Lamarn/ThermoAmpel/Dokumentation/Humidity_Conversion.png

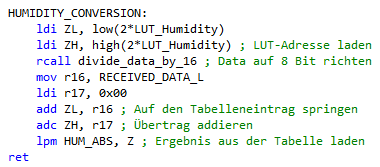
Dokumentation/Humidity_Conversion.png
