Lamarn/ThermoAmpel/Board/Thermoampel/v1microcontroller.brd

## EAGLE design Board/Thermoampel/v1microcontroller.brd (2018-10-14)

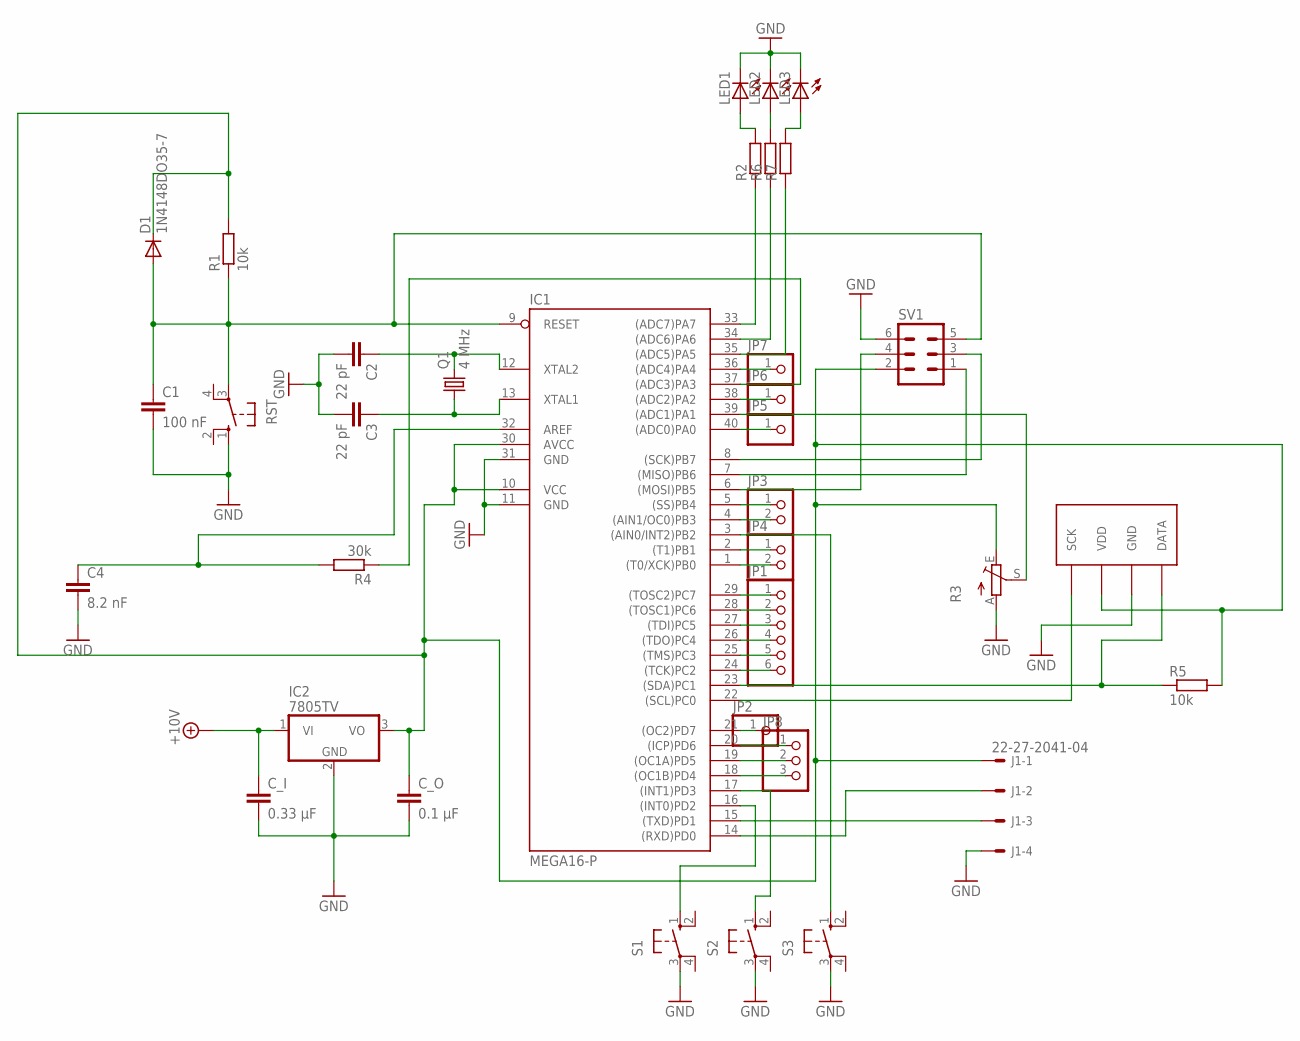
[picture p9: schematic v1microcontroller.sch]

Parts:
C1: 100 nF; C2.5-3
C2, C3: 22 pF; C2.5-3
C4: 8.2 nF; C2.5-3
C_I: 0.33 μF; C2.5-3
C_O: 0.1 μF; C2.5-3
D1: 1N4148DO35-7; DO35-7
IC1: MEGA16-P; DIL40
IC2: 7805TV; TO220V
J1: 22-27-2041-04; 6410-04
JP1: PINHD-1X6; 1X06
JP2, JP5, JP6, JP7: PINHD-1X1; 1X01
JP3, JP4: PINHD-1X2; 1X02
JP8: PINHD-1X3; 1X03
LED1, LED2, LED3: LED5MM
Q1: 4 MHz; HC49U-V
R1, R5: 10k; 0204/5
R2, R6, R7: R-EU_0204/5; 0204/5
R3: TRIM_EU-CT6; CT6
R4: 30k; 0204/5
RST: 10-XX; B3F-10XX
S1, S2, S3: 10-XX; B3F-10XX
SV1: ML6
U$1: SHT71; SHT7X

Connections:
+10V: C_I.1, IC2.1 (VI)
GND: C1.2, C2.2, C3.2, C4.2, C_I.2, C_O.2, IC1.11 (GND), IC1.31 (GND), IC2.2 (GND), J1.4, LED1.K (C), LED2.K (C), LED3.K (C), R3.A, RST.1 (S), S1.3, S2.3, S3.3, SV1.6, U$1.3 (GND)
unnamed: C1.1, D1.A, IC1.9 (RESET), R1.1, RST.3, SV1.5
unnamed: LED3.A, R7.2
unnamed: C_O.1, D1.C, IC1.10 (VCC), IC1.30 (AVCC), IC2.3 (VO), J1.1, R1.2, R3.E, R5.2, SV1.2, U$1.2 (VDD)
unnamed: IC1.33 ((ADC7)PA7), R2.1
unnamed: IC1.7 ((MISO)PB6), SV1.1
unnamed: IC1.6 ((MOSI)PB5), SV1.4
unnamed: LED2.A, R6.2
unnamed: C2.1, IC1.12 (XTAL2), Q1.2
unnamed: C3.1, IC1.13 (XTAL1), Q1.1
unnamed: IC1.39 ((ADC1)PA1), R3.S
unnamed: LED1.A, R2.2
unnamed: IC1.21 ((OC2)PD7), JP2.1
unnamed: C4.1, IC1.32 (AREF), R4.2
unnamed: IC1.8 ((SCK)PB7), SV1.3
unnamed: IC1.20 ((ICP)PD6), JP8.1
unnamed: IC1.19 ((OC1A)PD5), JP8.2
unnamed: IC1.18 ((OC1B)PD4), JP8.3
unnamed: IC1.29 ((TOSC2)PC7), JP1.1
unnamed: IC1.15 ((TXD)PD1), J1.3
unnamed: IC1.14 ((RXD)PD0), J1.2
unnamed: IC1.16 ((INT0)PD2), S1.1 (S)
unnamed: IC1.17 ((INT1)PD3), S2.1 (S)
unnamed: IC1.3 ((AIN0/INT2)PB2), S3.1 (S)
unnamed: IC1.22 ((SCL)PC0), U$1.1 (SCK)
unnamed: IC1.23 ((SDA)PC1), R5.1, U$1.4 (DATA)
unnamed: IC1.28 ((TOSC1)PC6), JP1.2
unnamed: IC1.27 ((TDI)PC5), JP1.3
unnamed: IC1.26 ((TDO)PC4), JP1.4
unnamed: IC1.25 ((TMS)PC3), JP1.5
unnamed: IC1.24 ((TCK)PC2), JP1.6
unnamed: IC1.5 ((SS)PB4), JP3.1
unnamed: IC1.4 ((AIN1/OC0)PB3), JP3.2
unnamed: IC1.2 ((T1)PB1), JP4.1
unnamed: IC1.1 ((T0/XCK)PB0), JP4.2
unnamed: IC1.34 ((ADC6)PA6), R6.1
unnamed: IC1.35 ((ADC5)PA5), R7.1
unnamed: IC1.40 ((ADC0)PA0), JP5.1
unnamed: IC1.37 ((ADC3)PA3), R4.1
unnamed: IC1.38 ((ADC2)PA2), JP6.1
unnamed: IC1.36 ((ADC4)PA4), JP7.1

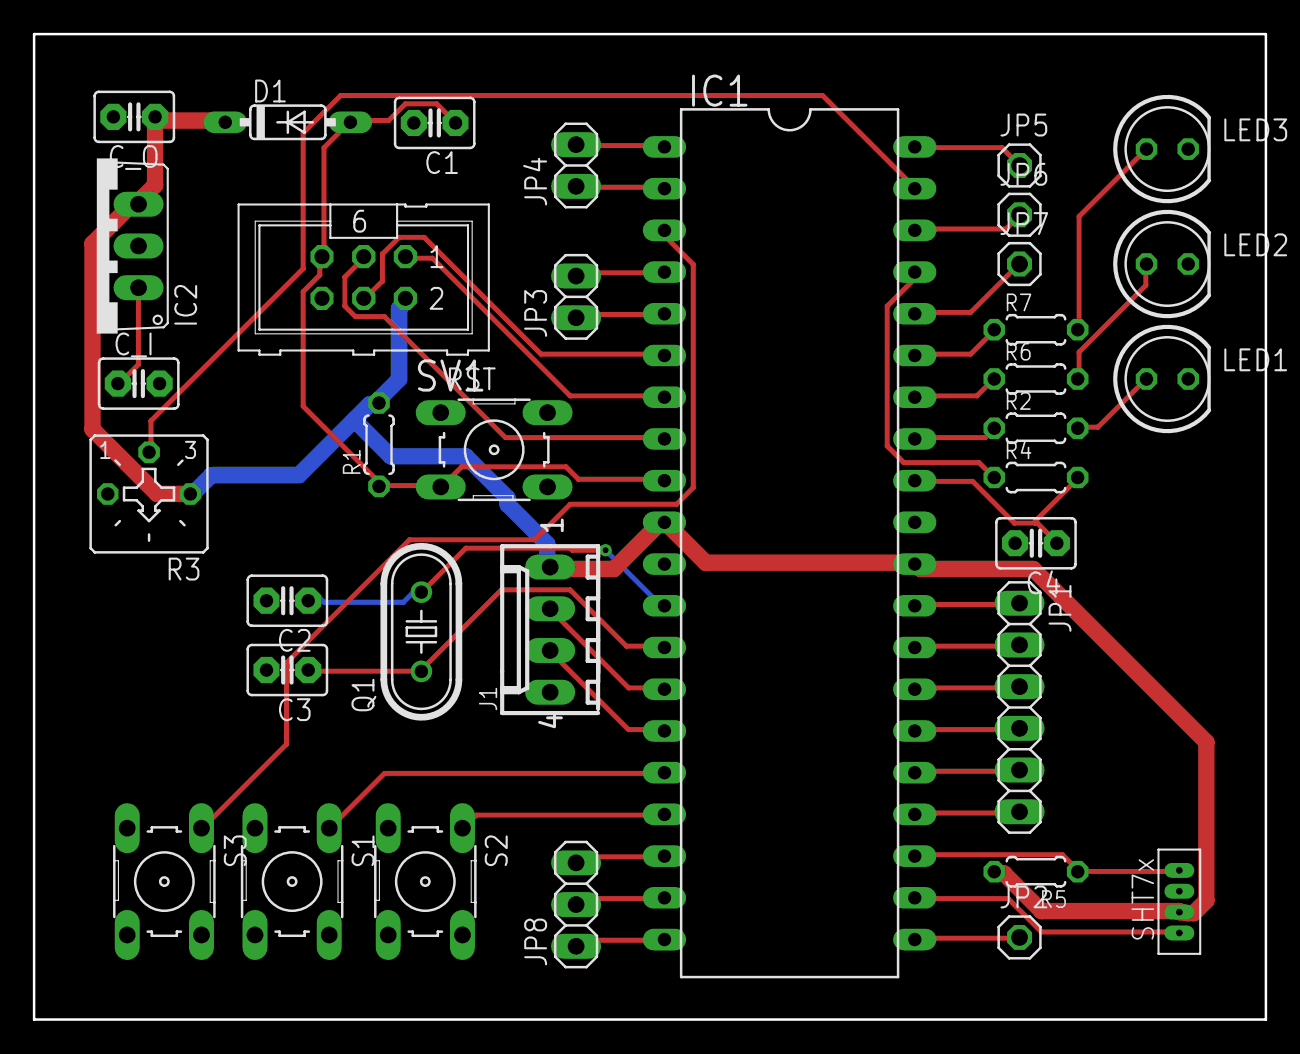
[picture p10: board v1microcontroller.brd from above]

Board: 2 copper layers, 75.0 x 60.0 mm, 35 parts (0 on the bottom side), 42 nets.
