Lamarn/ThermoAmpel/(commit log)

2018-09-18 LED bugfix: Internen pullup resistor aktiviert
    [main.asm]
2018-09-19 Routine für Delay von 500ms hinzugefügt, realisiert über 16-Bit Timer/Counter
2018-09-21 Eigentlich fertiger Code für TWI, aber festgestellt, dass Sensor das nicht unterstützt!
2018-09-23 - Kommunikation mit dem Sensor jetzt möglich - TWI Routine ausgelagert
2018-09-23 1) Leuchten der LEDs bedeutet jetzt Folgendes: - Rote LED: RH ist kleiner als 40 oder größer als 60 - Gelbe LED: Temperatur ist jetzt kleiner als 20°C oder größer als 23°C - Grüne LED: Beide Werte si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
    2) Code etwas verbessert und aufgeräumt.
2018-10-01 LUT für Umwandlung von Sensordaten hinzugefügt
2018-10-10 UART communication implemented, Interrupt tweaks
2018-10-14 Board Projektdateien hinzugefügt
    [v1microcontroller.brd, v1microcontroller.sch]
2018-10-14 Dateien angelegt für die Dokumentation
2018-10-26 Erster Text in der Zeit bei der Arbeit wo ich den Rechner nicht hatte xD
2018-11-26 Softwareaspekt der Dokumentation weiter ausgeführt
2018-11-26 Mehr Struktur im Softwarepart reingebracht und Sachen ergänzt, paar Aspekte sind noch offen.
2018-11-29 Abschnitt "Funktionsweise der Software" fertig
2018-12-03 Finale Änderungen an der Dokumentation
2018-12-04 Interrupts gefixt
2018-12-05 Bugfix bei Timer0_Interrupt
2018-12-05 Interruptteil aktualisiert. Finale Version!
2018-12-05 Interruptteil aktualisiert. Finale Version (dieses mal ganz sicher!)
